donpivo/TuningIndicator_EM84/README.md

Description: https://retronics.no/2024/02/22/diy-digital-em84-magic-eye-replacement/
