donpivo/TuningIndicator_EM84/Schematic/EM84_Base/production/EM84_Base_2023-12-29_16-26-52/bom.csv

Designator | Footprint | Quantity | Value | LCSC Part #
C1 | CP_Radial_D8.0mm_P3.50mm_EM84 | 1 | 1000µF 16V
D1, D2 | D_SOD-323_HandSoldering | 2 | 1N5819WS
F1 | 1206 | 1 | T1A
FB1 | 0805 | 1 | 330Ω@100MHz
J1 | EM84_Socket | 1 | Noval
J2 | PinSocket_1x03_P2.54mm_Vertical_alt | 1 | Pin header
