donpivo/TuningIndicator_EM84/Models/NovalBase.stl

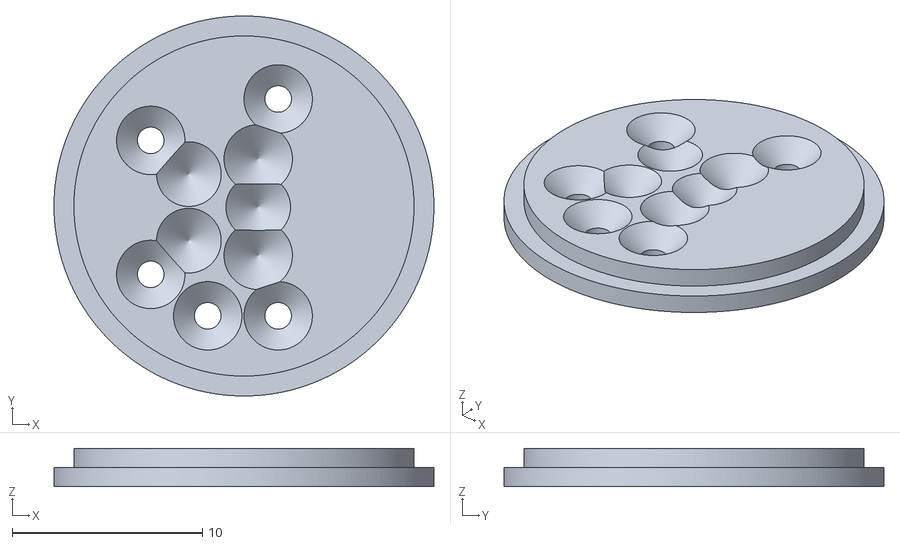
[picture p1: CAD file, 2024-02-22]
Models/NovalBase.stl
20.0 x 20.0 x 2.00
