donpivo/TuningIndicator_EM84/Schematic/EM84_Base/EM84_Base.step

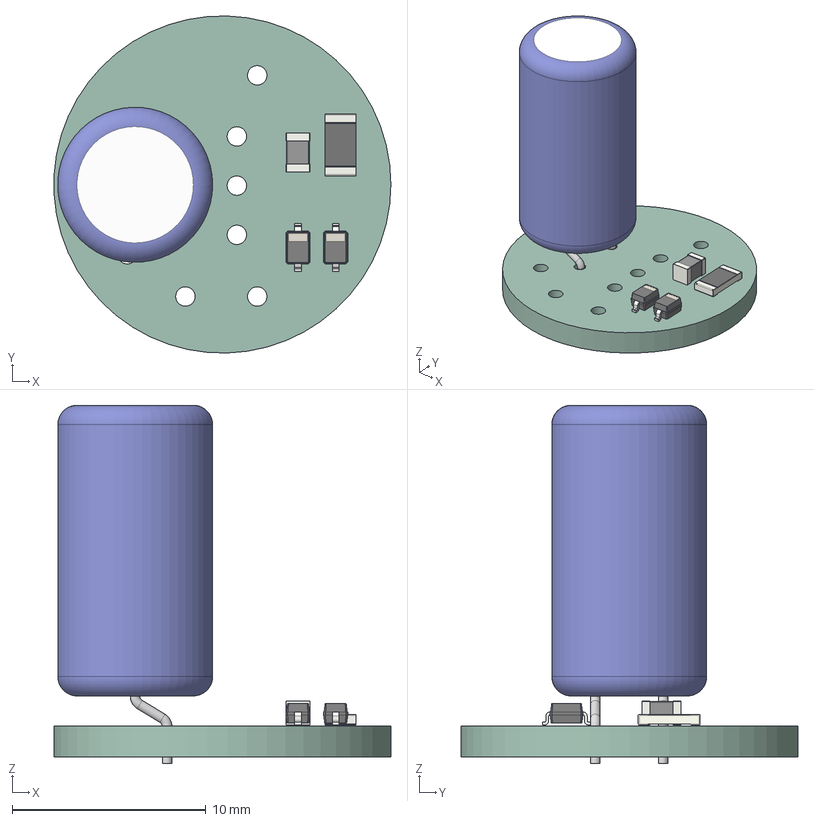
[picture p2: CAD file, 2024-02-22]
Schematic/EM84_Base/EM84_Base.step
17.4 x 17.4 x 18.5 mm
D_SOD_323 x 2
L_0805_2012Metric
Cap_Rad_08d_15h v7
Fuse_1206_3216Metric
EM84_Base PCB
