donpivo/TuningIndicator_EM84/Models/Lid.stl

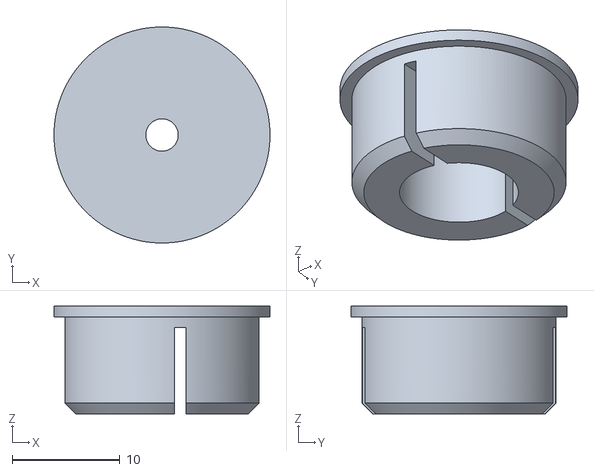
[picture p3: CAD file, 2024-02-22]
Models/Lid.stl
20.0 x 20.0 x 10.0
