donpivo/TuningIndicator_EM84/Schematic/EM84_Base/EM84_Base.kicad_pcb

## KiCad design Schematic/EM84_Base/EM84_Base.kicad_pcb (2024-02-22)

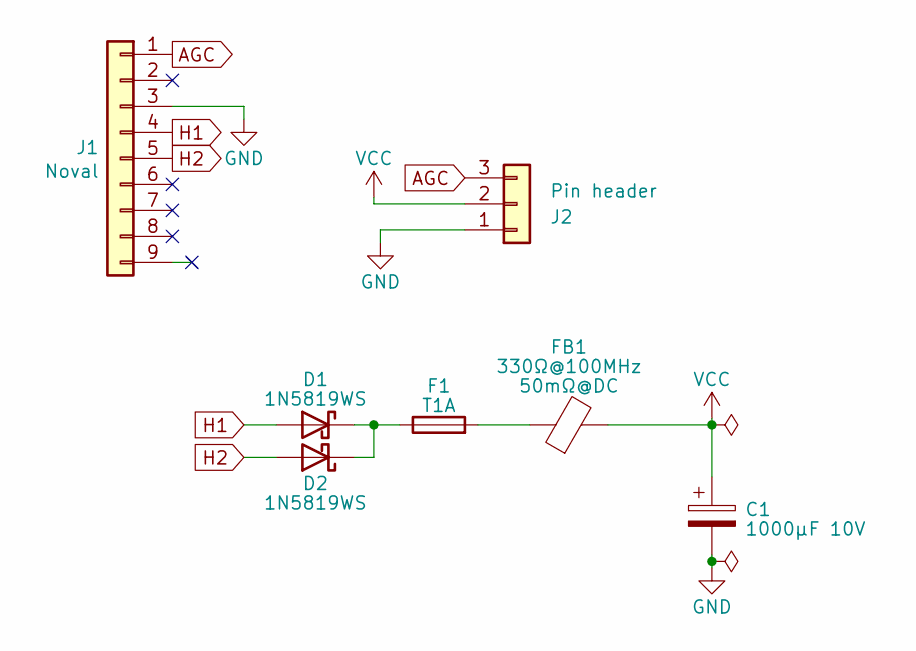
[picture p4: schematic EM84_Base.kicad_sch]

Parts:
C1: 1000µF 10V; CP_Radial_D8.0mm_P3.50mm_EM84
D1, D2: 1N5819WS; D_SOD-323_HandSoldering
F1: T1A; Fuse_1206_3216Metric
FB1: 330Ω@100MHz; L_0805_2012Metric_Pad1.15x1.40mm_HandSolder
J1: Noval; EM84_Socket
J2: Pin header; PinSocket_1x03_P2.54mm_Vertical_alt

Connections:
GND: C1.2, J1.3, J2.1
H1: D1.2 (A), J1.4
H2: D2.2 (A), J1.5
unnamed: D1.1 (K), D2.1 (K), F1.1
unnamed: F1.2, FB1.1
SIG: J1.1, J2.3
VCC: C1.1, FB1.2, J2.2

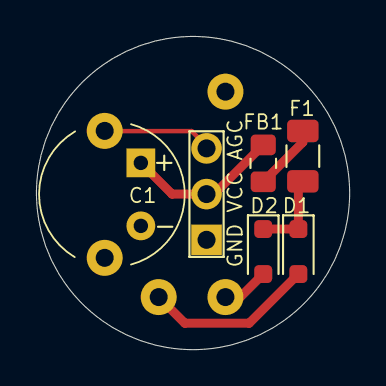
[picture p5: board EM84_Base.kicad_pcb from above]

Board: 2 copper layers, 17.4 x 17.4 mm, 7 parts (0 on the bottom side), 7 nets.
