donpivo/TuningIndicator_EM84/Schematic/EM84_OLED/EM84_OLED.kicad_pcb

## KiCad design Schematic/EM84_OLED/EM84_OLED.kicad_pcb (2024-02-22)

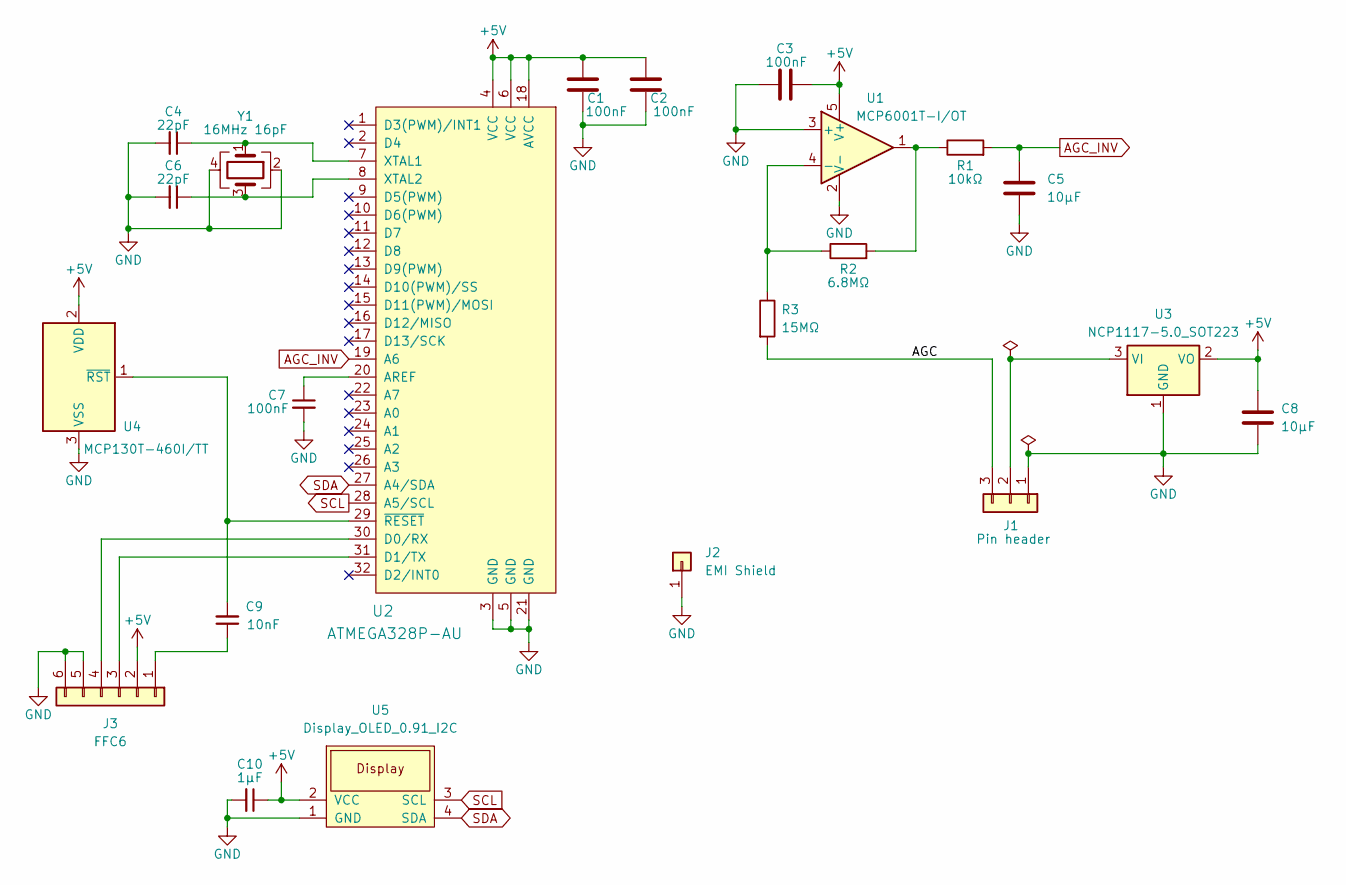
[picture p6: schematic EM84_OLED.kicad_sch, EM84 TuningIndicator, OLED board]

Parts:
C1, C2, C3, C7: 100nF; C_0603_1608Metric_Pad1.08x0.95mm_HandSolder
C4, C6: 22pF; C_0603_1608Metric_Pad1.08x0.95mm_HandSolder
C5, C8: 10µF; C_0603_1608Metric_Pad1.08x0.95mm_HandSolder
C9: 10nF; C_0603_1608Metric_Pad1.08x0.95mm_HandSolder
C10: 1µF; C_0603_1608Metric_Pad1.08x0.95mm_HandSolder
J1: Pin header; PinHeader_1x03_P2.54mm_Horizontal_Alt
J2: EMI Shield; EMI_Shield_MS192-10S
J3: FFC6; FFC_0527450697
R1: 10kΩ; R_0603_1608Metric_Pad0.98x0.95mm_HandSolder
R2: 6.8MΩ; R_0603_1608Metric_Pad0.98x0.95mm_HandSolder
R3: 15MΩ; R_0603_1608Metric_Pad0.98x0.95mm_HandSolder
U1: MCP6001T-I/OT; SOT-23-5
U2: ATMEGA328P-AU; TQFP-32_7x7mm_P0.8mm
U3: NCP1117-5.0_SOT223; SOT-223-3_TabPin2
U4: MCP130T-460I/TT; SOT-23
U5: Display_OLED_0.91_I2C; 0.91-OLED-4pin-128x32
Y1: 16MHz 16pF; Crystal_SMD_SeikoEpson_TSX3225-4Pin_3.2x2.5mm

Connections:
+5V: C1.2, C2.2, C3.2, C8.1, C10.1, J3.2, U1.5 (V+), U2.4 (VCC), U2.6 (VCC), U2.18 (AVCC), U3.2 (VO), U4.2 (VDD), U5.2 (VCC)
/AGC: J1.3, R3.2
AGC_INV: C5.1, R1.2, U2.19 (A6)
GND: C1.1, C2.1, C3.1, C4.2, C5.2, C6.2, C7.2, C8.2, C10.2, J1.1, J2.1, J3.5, J3.6, U1.2 (V-), U1.3 (+), U2.3 (GND), U2.5 (GND), U2.21 (GND), U3.1 (GND), U4.3 (VSS), U5.1 (GND), Y1.2, Y1.4
unnamed: J1.2, U3.3 (VI)
unnamed: C9.1, J3.1
unnamed: J3.3, U2.31 (D1/TX)
unnamed: J3.4, U2.30 (D0/RX)
unnamed: R1.1, R2.2, U1.1
unnamed: R2.1, R3.1, U1.4 (-)
unnamed: C7.1, U2.20 (AREF)
unnamed: C4.1, U2.7 (XTAL1), Y1.1
unnamed: C6.1, U2.8 (XTAL2), Y1.3
unnamed: C9.2, U2.29 (~RESET), U4.1 (~RST)
SCL: U2.28 (A5/SCL), U5.3 (SCL)
SDA: U2.27 (A4/SDA), U5.4 (SDA)

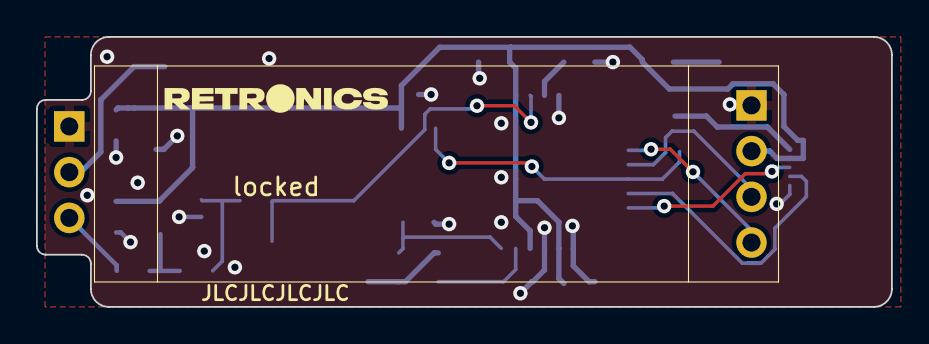
[picture p7: board EM84_OLED.kicad_pcb from above]

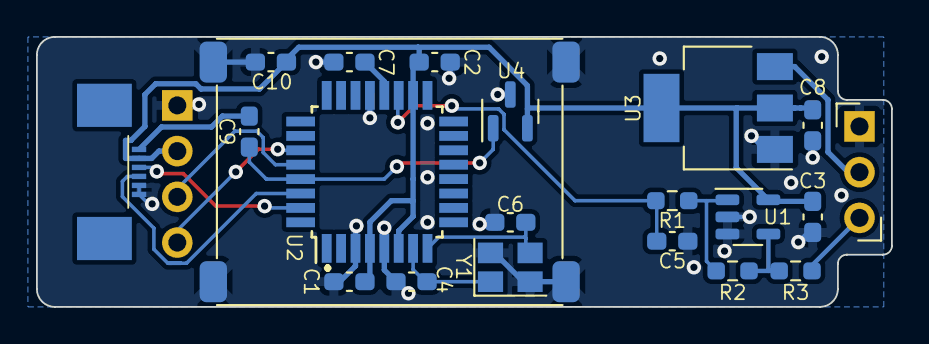
[picture p8: board EM84_OLED.kicad_pcb from below]

Board: 2 copper layers, 47.5 x 15.0 mm, 22 parts (21 on the bottom side), 16 nets.
