donpivo/TuningIndicator_EM84/(commit log)

2023-12-11 Updated PCB layout
    [EM84_Base.kicad_pcb, bom.csv, designators.csv, positions.csv]
2024-02-22 File cleanup
    [EM84_Base.kicad_pcb, EM84_Base.kicad_sch, EM84_Base.step, EM84_OLED.kicad_pcb, EM84_OLED.kicad_sch, Lid.stl, NovalBase.stl, bom.csv]
